NKNguyenLX/Buck_Converter/(list of files, drawings)

Other design files:
Hardware/Buck_converter.SchDoc
